emoninet2/Kingfisher-DAC16/README.md

# Kingfisher-DAC16
A 16 channel. 16-bit DAC board.
