emoninet2/Kingfisher-DAC16/Board/V1RevB/Kingfisher.kicad_pcb

## KiCad design Board/V1RevB/Kingfisher.kicad_pcb (2024-11-22)

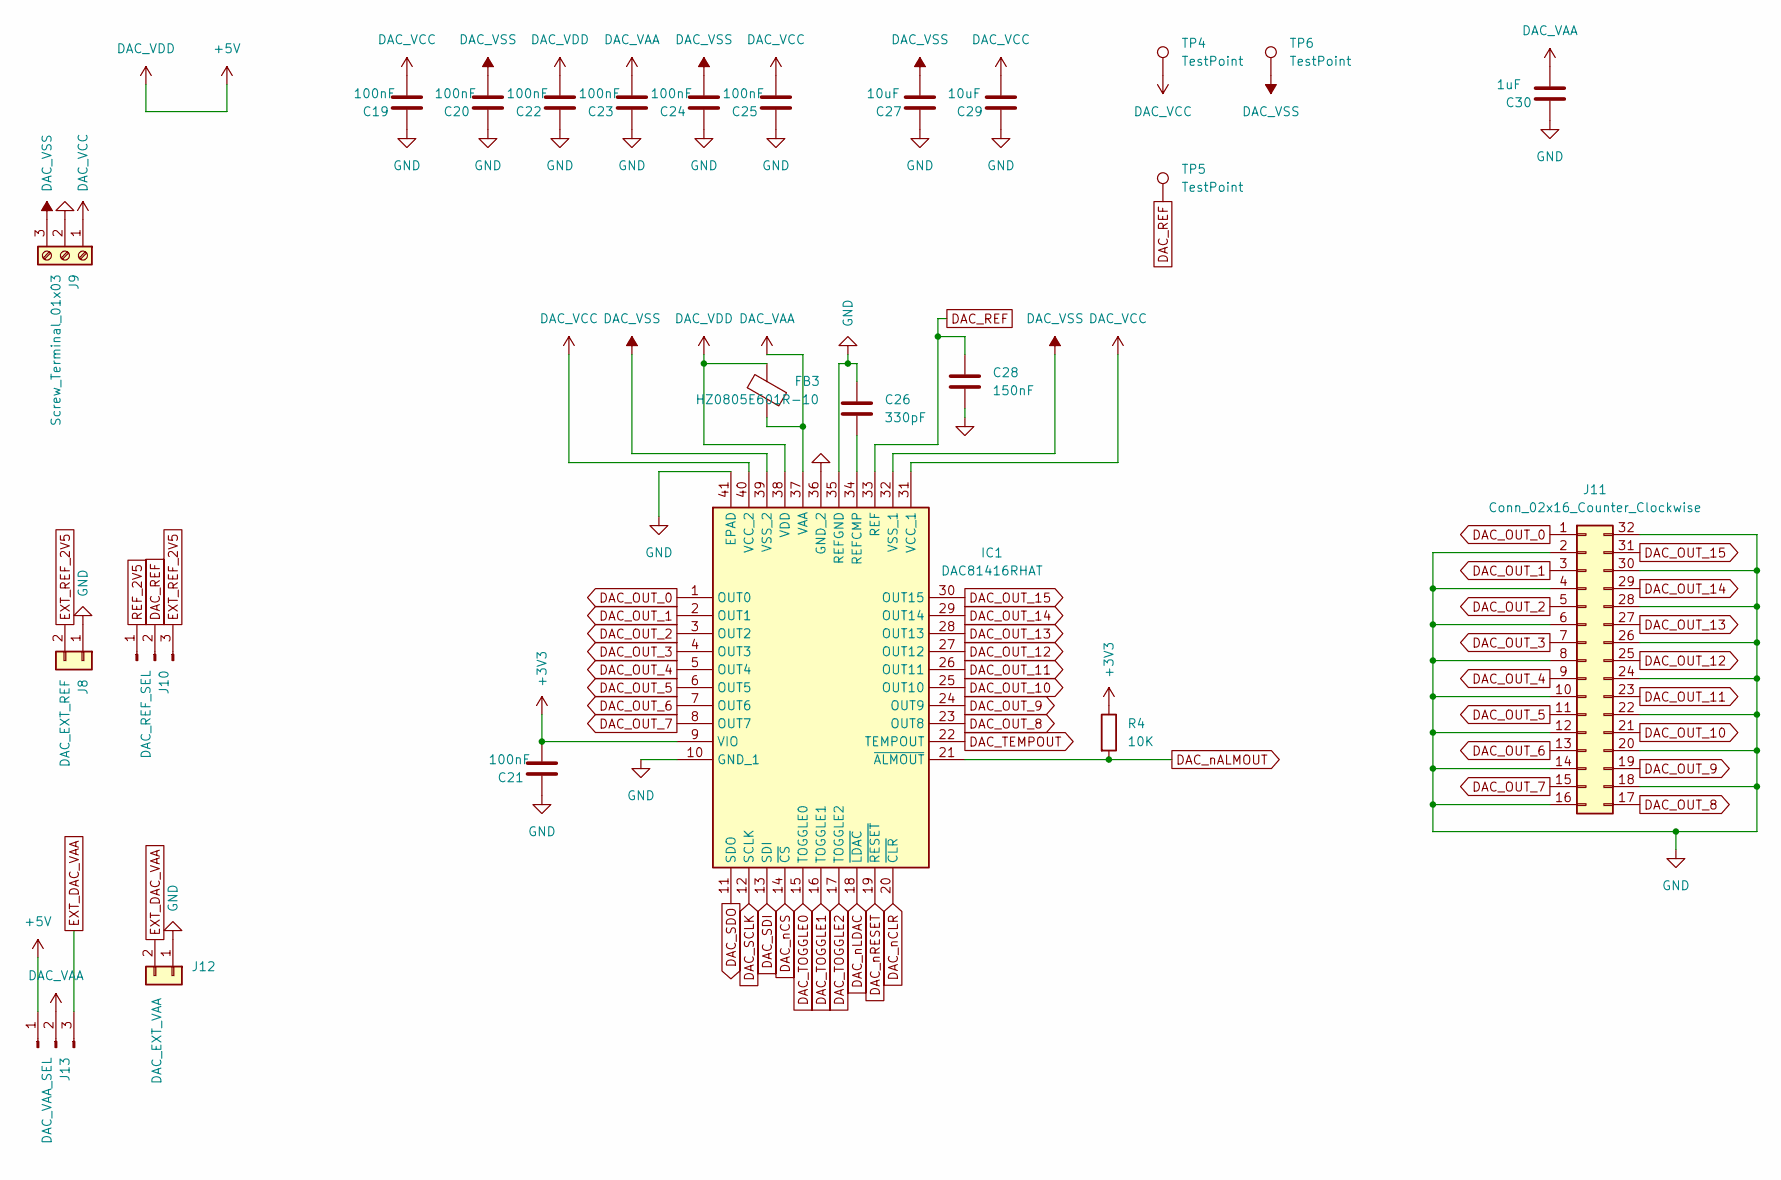
[picture p1: schematic dac_module.kicad_sch]

Parts:
C19, C20, C21, C22, C23, C24, C25: 100nF; C_0805_2012Metric; Manufacturer_Part_Number CL21B104KBCNNNC; LCSC C1711
C26: 330pF; C_0805_2012Metric; Mouser Part Number 08052C331KAT2A; Digi-Key Part Number 478-KGM21NR72D331KTCT-ND
C27, C29: 10uF; C_0805_2012Metric; Manufacturer_Part_Number CL21A106KOQNNNG; LCSC C307520
C28: 150nF; C_0805_2012Metric; Mouser Part Number C0805C154K5RACAUTO; Digi-Key Part Number 399-15888-1-ND
C30: 1uF; C_0805_2012Metric; Manufacturer_Part_Number CL21A105KBCLNNC; LCSC C318694
FB3: HZ0805E601R-10; L_0805_2012Metric; Manufacturer_Part_Number HZ0805E601R-10; Digi-Key Part Number 240-2399-1-ND
IC1: DAC81416RHAT; QFN50P600X600X100-41N-D; Mouser Part Number DAC81416RHAT
J8: DAC_EXT_REF; PinHeader_1x02_P2.54mm_Horizontal; Mouser Part Number MC34745; Farnell 1593426
J9: Screw_Terminal_01x03; TerminalBlock_MetzConnect_Type059_RT06303HBWC_1x03_P3.50mm_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; Mouser Part Number METZ CONNECT; Farnell 31059103
J10: DAC_REF_SEL; PinHeader_1x03_P2.54mm_Vertical; Manufacturer_Part_Number TSW-103-14-TM-S; Farnell 3398484
J11: Conn_02x16_Counter_Clockwise; PinSocket_2x16_P2.54mm_Horizontal; Mouser Part Number SSW-108-02-F-D-RA; Farnell 3661253
J12: DAC_EXT_VAA; PinHeader_1x02_P2.54mm_Horizontal; Mouser Part Number MC34745; Farnell 1593426
J13: DAC_VAA_SEL; PinHeader_1x03_P2.54mm_Vertical; Manufacturer_Part_Number TSW-103-14-TM-S; Farnell 3398484
R4: 10K; R_0805_2012Metric; Mouser Part Number CRCW080510K0JNEAIF; Farnell 1739242
TP4, TP5, TP6: TestPoint; TestPoint_Pad_1.0x1.0mm

Connections:
+3V3: C21.2, IC1.9 (VIO), R4.1; also elsewhere on the board
+5V: C22.2, FB3.1, IC1.38 (VDD), J13.1; also elsewhere on the board
DAC_OUT_0: IC1.1 (OUT0), J11.1
DAC_OUT_1: IC1.2 (OUT1), J11.3
DAC_OUT_2: IC1.3 (OUT2), J11.5
DAC_OUT_3: IC1.4 (OUT3), J11.7
DAC_OUT_4: IC1.5 (OUT4), J11.9
DAC_OUT_5: IC1.6 (OUT5), J11.11
DAC_OUT_6: IC1.7 (OUT6), J11.13
DAC_OUT_7: IC1.8 (OUT7), J11.15
DAC_OUT_8: IC1.23 (OUT8), J11.17
DAC_OUT_9: IC1.24 (OUT9), J11.19
DAC_OUT_10: IC1.25 (OUT10), J11.21
DAC_OUT_11: IC1.26 (OUT11), J11.23
DAC_OUT_12: IC1.27 (OUT12), J11.25
DAC_OUT_13: IC1.28 (OUT13), J11.27
DAC_OUT_14: IC1.29 (OUT14), J11.29
DAC_OUT_15: IC1.30 (OUT15), J11.31
DAC_REF: C28.1, IC1.33 (REF), J10.2, TP5.1
DAC_SCLK: IC1.12 (SCLK); also elsewhere on the board
DAC_SDI: IC1.13 (SDI); also elsewhere on the board
DAC_SDO: IC1.11 (SDO); also elsewhere on the board
DAC_TEMPOUT: IC1.22 (TEMPOUT)
DAC_TOGGLE0: IC1.15 (TOGGLE0); also elsewhere on the board
DAC_TOGGLE1: IC1.16 (TOGGLE1); also elsewhere on the board
DAC_TOGGLE2: IC1.17 (TOGGLE2); also elsewhere on the board
DAC_VAA: C23.2, C30.2, FB3.2, IC1.37 (VAA), J13.2
DAC_VCC: C19.2, C25.2, C29.2, IC1.31 (VCC_1), IC1.40 (VCC_2), J9.1, TP4.1
DAC_VSS: C20.2, C24.2, C27.2, IC1.32 (VSS_1), IC1.39 (VSS_2), J9.3, TP6.1
DAC_nALMOUT: IC1.21 (~ALMOUT), R4.2; also elsewhere on the board
DAC_nCLR: IC1.20 (~CLR); also elsewhere on the board
DAC_nCS: IC1.14 (~CS); also elsewhere on the board
DAC_nLDAC: IC1.18 (~LDAC); also elsewhere on the board
DAC_nRESET: IC1.19 (~RESET); also elsewhere on the board
EXT_DAC_VAA: J12.2, J13.3
EXT_REF_2V5: J8.2, J10.3
GND: C19.1, C20.1, C21.1, C22.1, C23.1, C24.1, C25.1, C26.1, C27.1, C28.2, C29.1, C30.1, IC1.10 (GND_1), IC1.35 (REFGND), IC1.36 (GND_2), IC1.41 (EPAD), J8.1, J9.2, J11.2, J11.4, J11.6, J11.8, J11.10, J11.12, J11.14, J11.16, J11.18, J11.20, J11.22, J11.24, J11.26, J11.28, J11.30, J11.32, J12.1; also elsewhere on the board
unnamed: C26.2, IC1.34 (REFCMP)
REF_2V5: J10.1; also elsewhere on the board

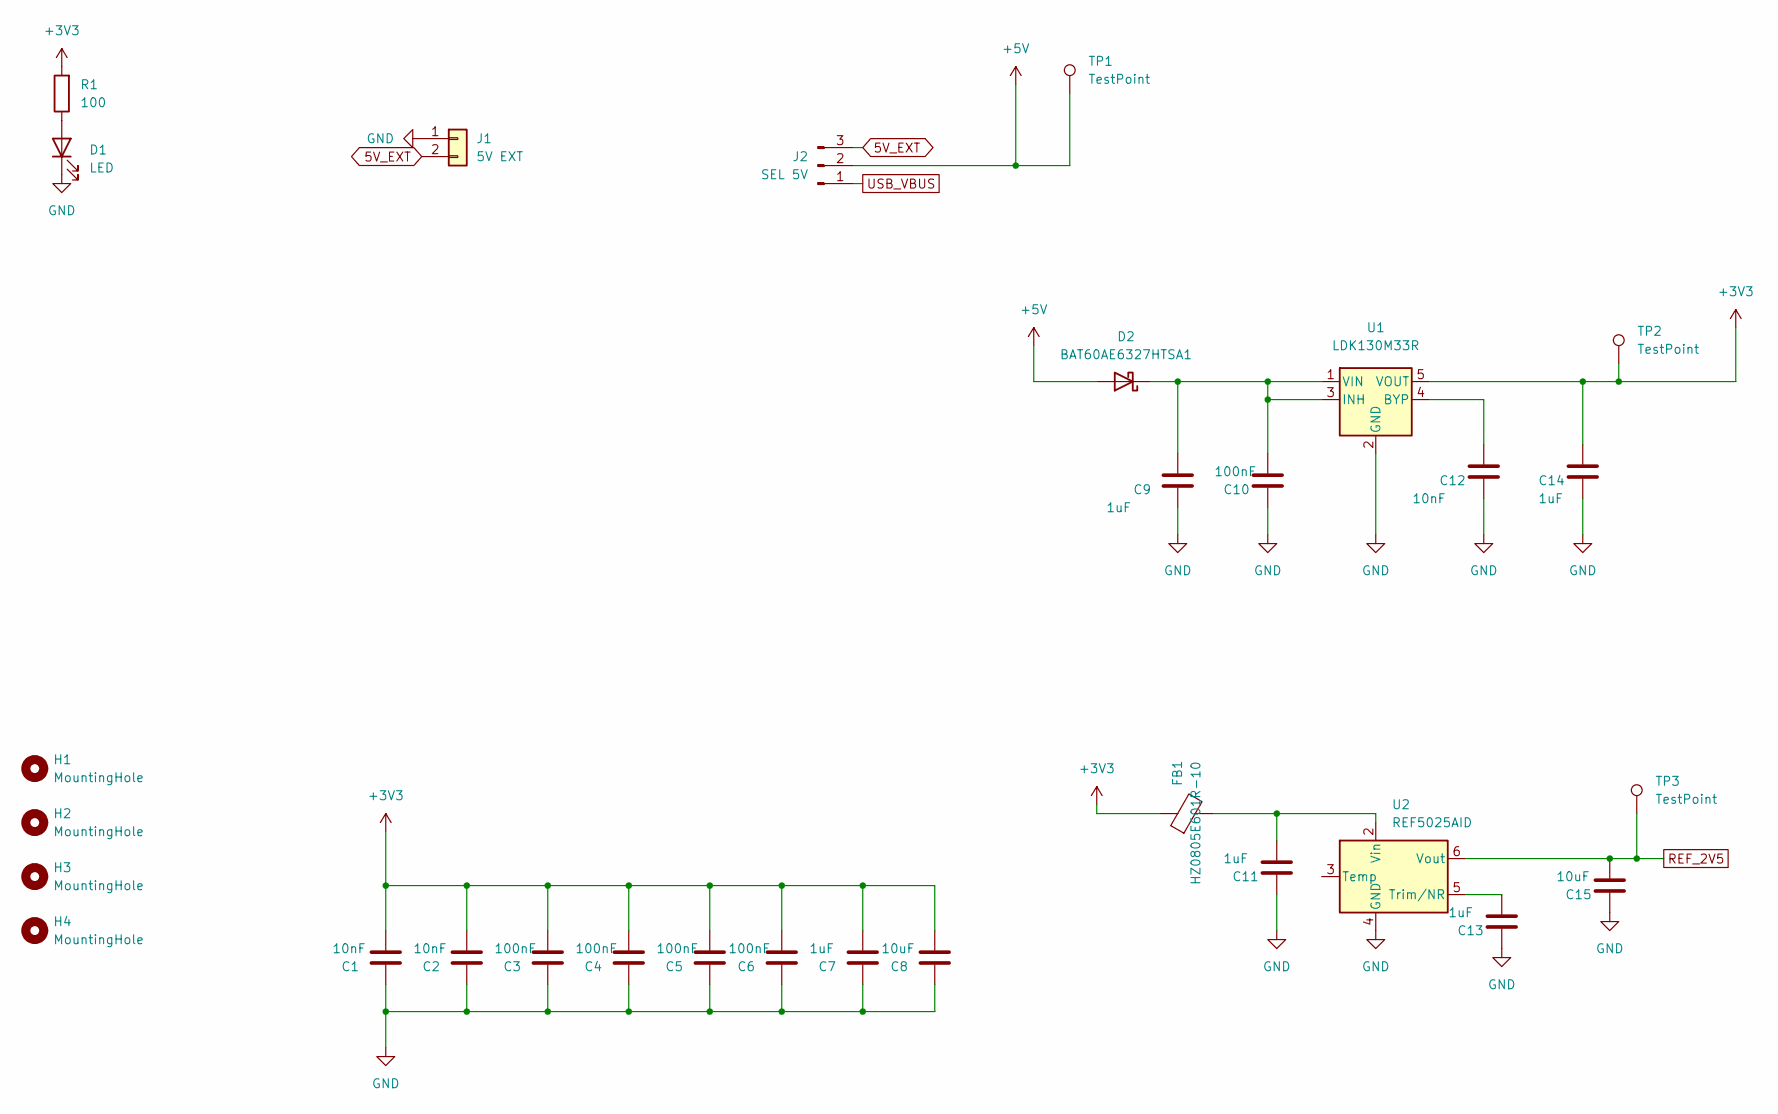
[picture p2: schematic power.kicad_sch]

Parts:
C1, C2, C12: 10nF; C_0805_2012Metric; Manufacturer_Part_Number CL21B103KBANNNC; LCSC C1710
C3, C4, C5, C6, C10: 100nF; C_0805_2012Metric; Manufacturer_Part_Number CL21B104KBCNNNC; LCSC C1711
C7, C9, C11, C13, C14: 1uF; C_0805_2012Metric; Manufacturer_Part_Number CL21A105KBCLNNC; LCSC C318694
C8, C15: 10uF; C_0805_2012Metric; Manufacturer_Part_Number CL21A106KOQNNNG; LCSC C307520
D1: LED; LED_0805_2012Metric; Manufacturer_Part_Number LTST-C191KRKT; LCSC C125099
D2: BAT60AE6327HTSA1; D_SOD-323; Manufacturer_Part_Number BAT60AE6327HTSA1; Digi-Key Part Number BAT60AE6327HTSA1CT-ND
FB1: HZ0805E601R-10; L_0805_2012Metric; Manufacturer_Part_Number HZ0805E601R-10; Digi-Key Part Number 240-2399-1-ND
H1, H2, H3, H4: MountingHole; MountingHole_3mm
J1: 5V EXT; PinHeader_1x02_P2.54mm_Horizontal; Manufacturer_Part_Number TSW-102-14-TM-S; Farnell 1593426
J2: SEL 5V; PinHeader_1x03_P2.54mm_Vertical; Manufacturer_Part_Number TSW-103-14-TM-S; Farnell 3398484
R1: 100; R_0805_2012Metric; Manufacturer_Part_Number AC0805FR-07100RL; Farnell 1652906
TP1, TP2, TP3: TestPoint; TestPoint_Pad_1.0x1.0mm
U1: LDK130M33R; SOT-23-5; Manufacturer_Part_Number LD3985M33R; LCSC C46243
U2: REF5025AID; SOIC-8_3.9x4.9mm_P1.27mm; Mouser Part Number REF5025AID; Digi-Key Part Number 296-22203-5-ND

Connections:
5V_EXT: J1.2, J2.3
+3V3: C1.2, C2.2, C3.2, C4.2, C5.2, C6.2, C7.2, C8.2, C14.2, FB1.1, R1.2, TP2.1, U1.5 (VOUT); also elsewhere on the board
+5V: D2.2 (A), J2.2, TP1.1; also elsewhere on the board
GND: C1.1, C2.1, C3.1, C4.1, C5.1, C6.1, C7.1, C8.1, C9.1, C10.1, C11.1, C12.1, C13.1, C14.1, C15.1, D1.1 (K), J1.1, U1.2 (GND), U2.4 (GND); also elsewhere on the board
unnamed: D1.2 (A), R1.1
unnamed: C9.2, C10.2, D2.1 (K), U1.1 (VIN), U1.3 (INH)
unnamed: C12.2, U1.4 (BYP)
unnamed: C13.2, U2.5 (Trim/NR)
unnamed: C11.2, FB1.2, U2.2 (Vin)
REF_2V5: C15.2, TP3.1, U2.6 (Vout); also elsewhere on the board
USB_VBUS: J2.1; also elsewhere on the board

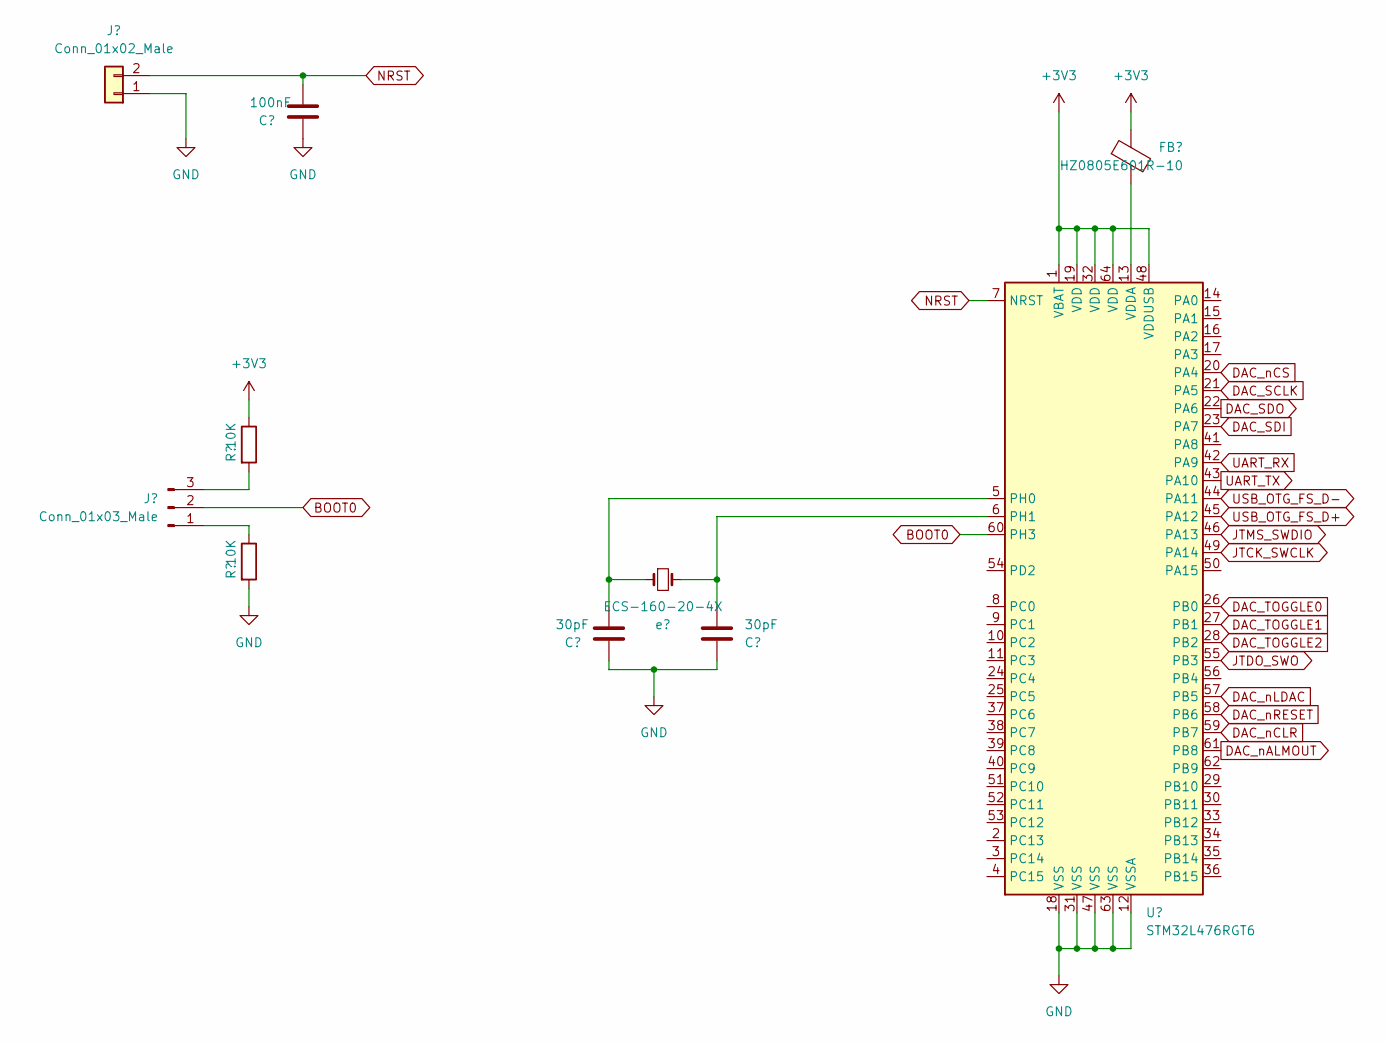
[picture p3: schematic mcu.kicad_sch]

Parts:
C16: 100nF; C_0805_2012Metric; Manufacturer_Part_Number CL21B104KBCNNNC; LCSC C1711
C17, C18: 30pF; C_0805_2012Metric; Manufacturer_Part_Number CL21C200JBANNNC; LCSC C1798
FB2: HZ0805E601R-10; L_0805_2012Metric; Manufacturer_Part_Number HZ0805E601R-10; Digi-Key Part Number 240-2399-1-ND
J3: Conn_01x02_Male; PinHeader_1x02_P2.54mm_Horizontal; Manufacturer_Part_Number TSW-102-14-TM-S; Farnell MC34745
J4: Conn_01x03_Male; PinHeader_1x03_P2.54mm_Vertical; Manufacturer_Part_Number TSW-103-14-TM-S; Farnell 3398484
R2, R3: 10K; R_0805_2012Metric; Manufacturer_Part_Number ERA-6AEB103V; Farnell 1739242
U3: STM32L476RGT6; LQFP-64_10x10mm_P0.5mm; Manufacturer_Part_Number STM32L476RGT6; LCSC C74797
e1: ECS-160-20-4X; Crystal_HC49-4H_Vertical; Manufacturer_Part_Number 9B-16.000MAAE-B; LCSC C2636524

Connections:
+3V3: FB2.1, R2.1, U3.1 (VBAT), U3.19 (VDD), U3.32 (VDD), U3.48 (VDDUSB), U3.64 (VDD); also elsewhere on the board
BOOT0: J4.2, U3.60 (PH3)
DAC_SCLK: U3.21 (PA5); also elsewhere on the board
DAC_SDI: U3.23 (PA7); also elsewhere on the board
DAC_SDO: U3.22 (PA6); also elsewhere on the board
DAC_TOGGLE0: U3.26 (PB0); also elsewhere on the board
DAC_TOGGLE1: U3.27 (PB1); also elsewhere on the board
DAC_TOGGLE2: U3.28 (PB2); also elsewhere on the board
DAC_nALMOUT: U3.61 (PB8); also elsewhere on the board
DAC_nCLR: U3.59 (PB7); also elsewhere on the board
DAC_nCS: U3.20 (PA4); also elsewhere on the board
DAC_nLDAC: U3.57 (PB5); also elsewhere on the board
DAC_nRESET: U3.58 (PB6); also elsewhere on the board
GND: C16.1, C17.1, C18.1, J3.1, R3.2, U3.12 (VSSA), U3.18 (VSS), U3.31 (VSS), U3.47 (VSS), U3.63 (VSS); also elsewhere on the board
JTCK_SWCLK: U3.49 (PA14); also elsewhere on the board
JTDO_SWO: U3.55 (PB3); also elsewhere on the board
JTMS_SWDIO: U3.46 (PA13); also elsewhere on the board
NRST: C16.2, J3.2, U3.7 (NRST); also elsewhere on the board
unnamed: J4.1, R3.1
unnamed: J4.3, R2.2
unnamed: C17.2, U3.5 (PH0), e1.1
unnamed: C18.2, U3.6 (PH1), e1.2
unnamed: FB2.2, U3.13 (VDDA)
UART_RX: U3.42 (PA9); also elsewhere on the board
UART_TX: U3.43 (PA10); also elsewhere on the board
USB_OTG_FS_D+: U3.45 (PA12); also elsewhere on the board
USB_OTG_FS_D-: U3.44 (PA11); also elsewhere on the board

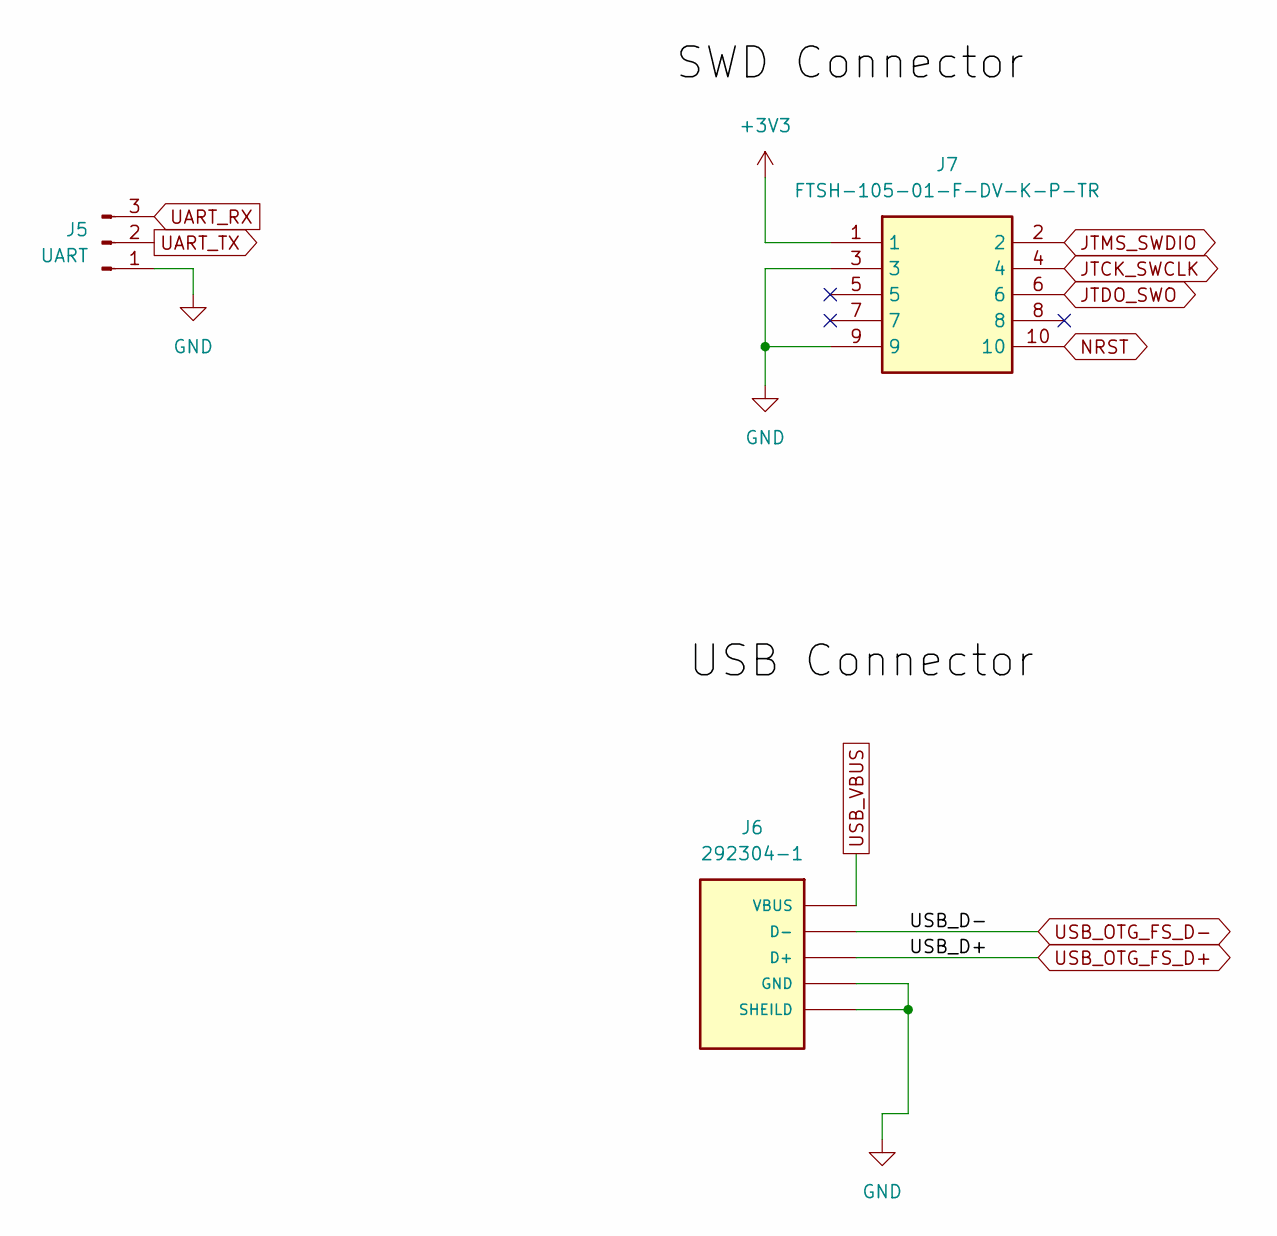
[picture p4: schematic connectors.kicad_sch]

Parts:
J5: UART; PinHeader_1x03_P2.54mm_Horizontal; Manufacturer_Part_Number TSW-103-14-TM-S; Farnell 1593427
J6: 292304-1; TE_292304-1; Manufacturer_Part_Number 292304-1; LCSC C86462
J7: FTSH-105-01-F-DV-K-P-TR; FTSH-105-XX-YYY-DV-K-P-TR; Mouser Part Number FTSH-105-01-F-DV-K-P-TR

Connections:
+3V3: J7.1; also elsewhere on the board
GND: J5.1, J6.0 (SHEILD), J6.4 (GND), J7.3, J7.9; also elsewhere on the board
JTCK_SWCLK: J7.4; also elsewhere on the board
JTDO_SWO: J7.6; also elsewhere on the board
JTMS_SWDIO: J7.2; also elsewhere on the board
NRST: J7.10; also elsewhere on the board
UART_RX: J5.3; also elsewhere on the board
UART_TX: J5.2; also elsewhere on the board
USB_OTG_FS_D+: J6.3 (D+); also elsewhere on the board
USB_OTG_FS_D-: J6.2 (D-); also elsewhere on the board
USB_VBUS: J6.1 (VBUS); also elsewhere on the board

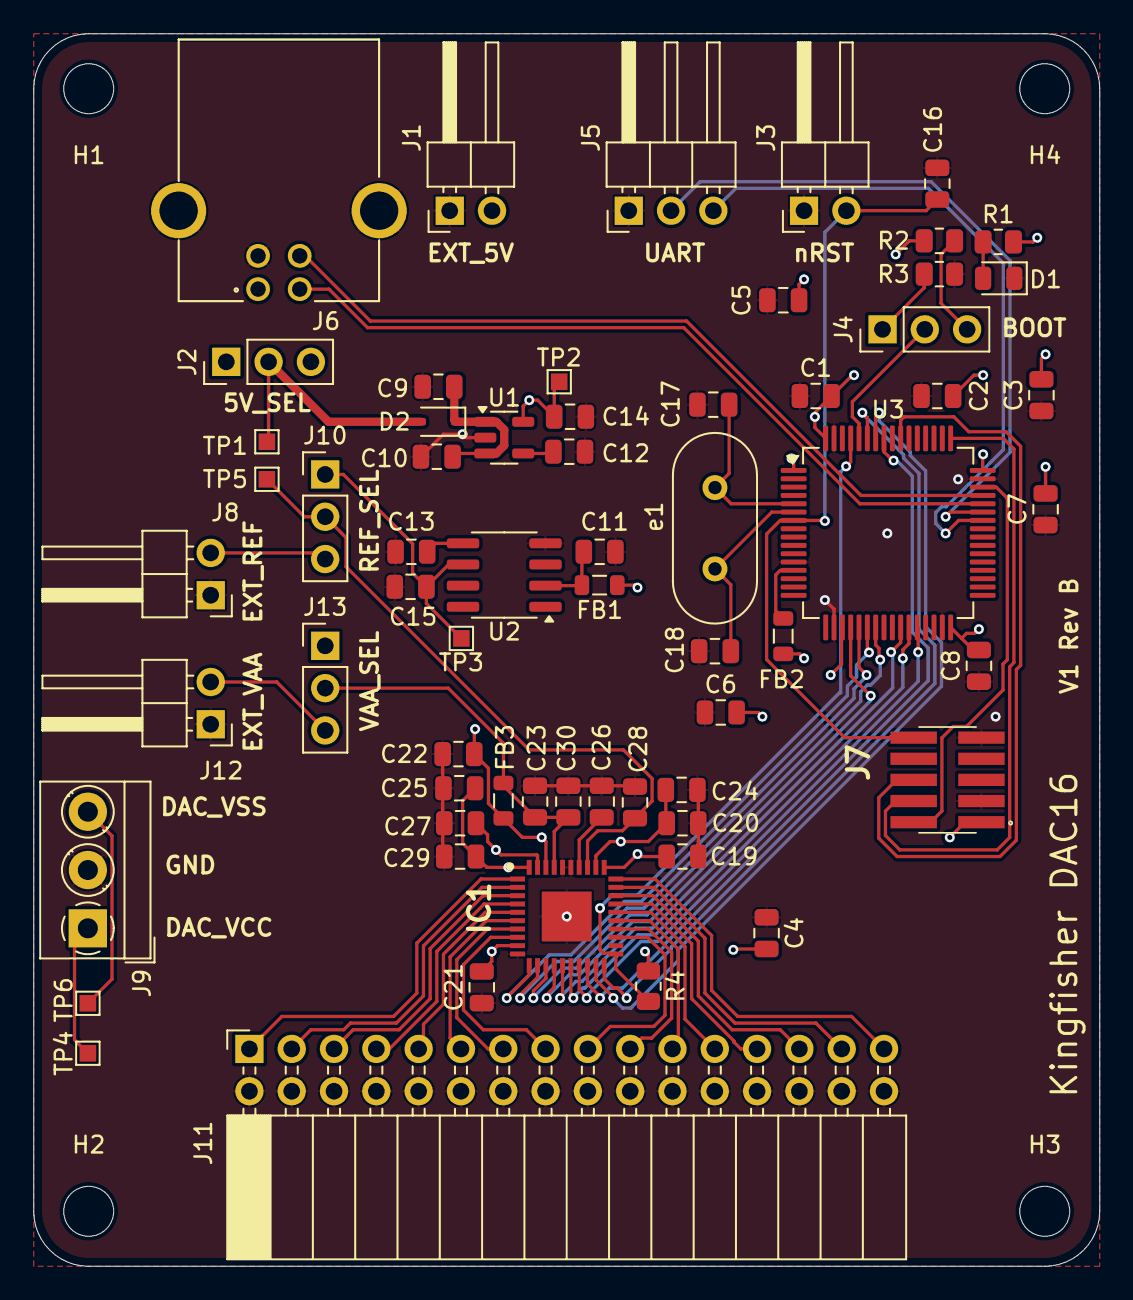
[picture p5: board Board/V1RevB/Kingfisher.kicad_pcb from above]

Board: 4 copper layers, 64.0 x 74.0 mm, 67 parts (0 on the bottom side), 59 nets.
