emoninet2/Kingfisher-DAC16/Board/V1RevA/Kingfisher.kicad_pcb

## KiCad design Board/V1RevA/Kingfisher.kicad_pcb (2024-10-19)

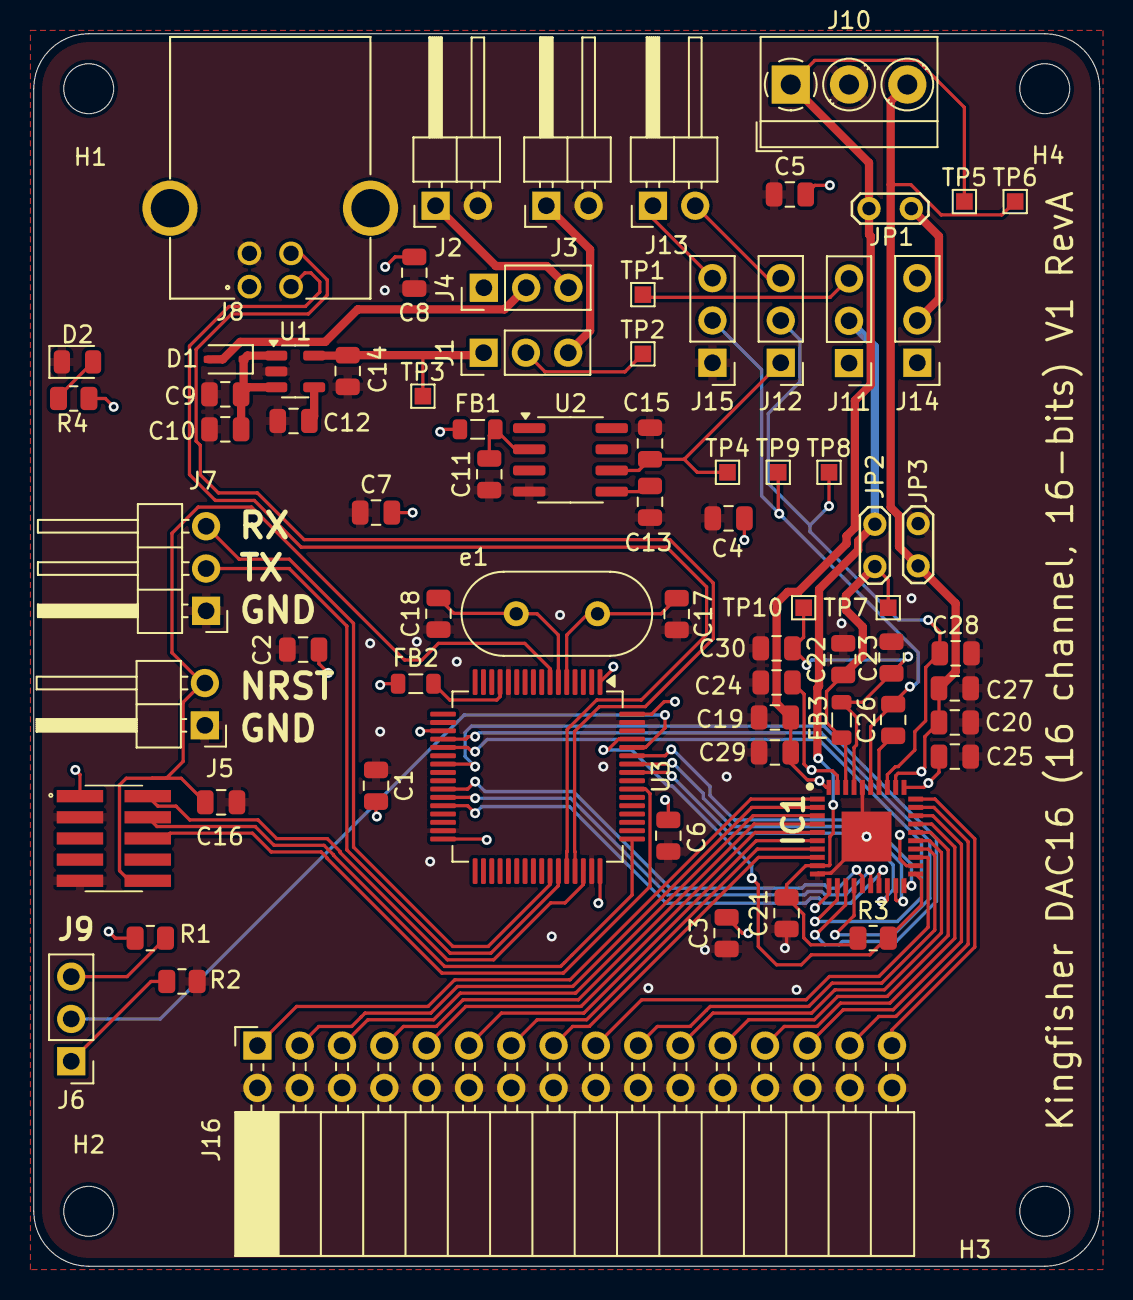
[picture p6: board Board/V1RevA/Kingfisher.kicad_pcb from above]

Board: 4 copper layers, 64.0 x 74.0 mm, 77 parts (0 on the bottom side), 64 nets.

Parts:
C1, C2, C12: 10nF; C_0805_2012Metric
C3, C4, C5, C6, C10, C16, C19, C20, C21, C22, C23, C24, C25: 100nF; C_0805_2012Metric
C7, C9, C11, C13, C14, C30: 1uF; C_0805_2012Metric
C8, C15, C27, C29: 10uF; C_0805_2012Metric
C17, C18: 30pF; C_0805_2012Metric
C26: 330pF; C_0805_2012Metric
C28: 150nF; C_0805_2012Metric
D1: BAT60AE6327HTSA1; D_SOD-323
D2: LED; LED_0805_2012Metric
FB1, FB2, FB3: HZ0805E601R-10; L_0805_2012Metric
H1, H2, H3, H4: MountingHole; MountingHole_3mm
IC1: DAC81416RHAT; QFN50P600X600X100-41N-D
J1: SEL 3V3; PinHeader_1x03_P2.54mm_Vertical
J2: 5V EXT; PinHeader_1x02_P2.54mm_Horizontal
J3: 3V3 EXT; PinHeader_1x02_P2.54mm_Horizontal
J4: SEL 5V; PinHeader_1x03_P2.54mm_Vertical
J5: Conn_01x02_Male; PinHeader_1x02_P2.54mm_Horizontal
J6: Conn_01x03_Male; PinHeader_1x03_P2.54mm_Vertical
J7: UART; PinHeader_1x03_P2.54mm_Horizontal
J8: 292304-1; TE_292304-1
J9: FTSH-105-01-F-DV-K-P-TR; FTSH-105-XX-YYY-DV-K-P-TR
J10: Screw_Terminal_01x03; TerminalBlock_MetzConnect_Type059_RT06303HBWC_1x03_P3.50mm_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
J11, J14: DAC_VDD_SEL; PinHeader_1x03_P2.54mm_Vertical
J12, J15: DAC_REF_SEL; PinHeader_1x03_P2.54mm_Vertical
J13: DAC_EXT_REF; PinHeader_1x02_P2.54mm_Horizontal
J16: Conn_02x16_Counter_Clockwise; PinSocket_2x16_P2.54mm_Horizontal
JP1, JP2, JP3: Jumper_01x02_2.54mm; TestPoint_2Pads_Pitch2.54mm_Drill0.8mm
R1, R2, R3: 10K; R_0805_2012Metric
R4: 100; R_0805_2012Metric
TP1, TP2, TP3, TP4, TP5, TP6, TP7, TP8, TP9, TP10: TestPoint; TestPoint_Pad_1.0x1.0mm
U1: LDK130M33R; SOT-23-5
U2: REF5025AID; SOIC-8_3.9x4.9mm_P1.27mm
U3: STM32L476RGT6; LQFP-64_10x10mm_P0.5mm
e1: ECS-160-20-4X; Crystal_HC49-4H_Vertical

Connections:
3.3V_EXT: J1.3, J3.1
3.3V_REG: C14.2, J1.1, TP3.1, U1.5 (VOUT)
5V_EXT: J2.1, J4.3
+3V3: C1.2, C2.2, C3.2, C4.2, C5.2, C6.2, C7.2, C8.2, FB1.1, FB2.1, J1.2, J9.1, J11.1, J14.1, R1.1, R4.2, TP2.1, U3.1 (VBAT), U3.19 (VDD), U3.32 (VDD), U3.48 (VDDUSB), U3.64 (VDD)
+5V: D1.2 (A), J4.2, J11.3, J14.3, TP1.1
BOOT0: J6.2, U3.60 (PH3)
DAC_GNDREF: C26.1, IC1.35 (REFGND), J15.2, TP9.1
DAC_OUT_0: IC1.1 (OUT0), J16.1
DAC_OUT_1: IC1.2 (OUT1), J16.3
DAC_OUT_2: IC1.3 (OUT2), J16.5
DAC_OUT_3: IC1.4 (OUT3), J16.7
DAC_OUT_4: IC1.5 (OUT4), J16.9
DAC_OUT_5: IC1.6 (OUT5), J16.11
DAC_OUT_6: IC1.7 (OUT6), J16.13
DAC_OUT_7: IC1.8 (OUT7), J16.15
DAC_OUT_8: IC1.23 (OUT8), J16.17
DAC_OUT_9: IC1.24 (OUT9), J16.19
DAC_OUT_10: IC1.25 (OUT10), J16.21
DAC_OUT_11: IC1.26 (OUT11), J16.23
DAC_OUT_12: IC1.27 (OUT12), J16.25
DAC_OUT_13: IC1.28 (OUT13), J16.27
DAC_OUT_14: IC1.29 (OUT14), J16.29
DAC_OUT_15: IC1.30 (OUT15), J16.31
DAC_REF: C28.1, IC1.33 (REF), J12.2, TP8.1
DAC_SCLK: IC1.12 (SCLK), U3.21 (PA5)
DAC_SDI: IC1.13 (SDI), U3.23 (PA7)
DAC_TOGGLE0: IC1.15 (TOGGLE0), U3.26 (PB0)
DAC_TOGGLE1: IC1.16 (TOGGLE1), U3.27 (PB1)
DAC_TOGGLE2: IC1.17 (TOGGLE2), U3.28 (PB2)
DAC_VAA: C23.2, C30.2, FB3.2, IC1.37 (VAA), TP10.1
DAC_VCC: C19.2, C25.2, C29.2, IC1.31 (VCC_1), IC1.40 (VCC_2), J10.1, JP1.1 (A), TP5.1
DAC_VDD: C22.2, FB3.1, IC1.38 (VDD), JP2.2 (B), TP7.1
DAC_VIO: C21.2, IC1.9 (VIO), J11.2, JP2.1 (A), R3.1
DAC_VSS: C20.2, C24.2, C27.2, IC1.32 (VSS_1), IC1.39 (VSS_2), J10.3, JP3.1 (A), TP6.1
DAC_nALMOUT: IC1.21 (~ALMOUT), R3.2, U3.61 (PB8)
DAC_nCLR: IC1.20 (~CLR), U3.59 (PB7)
DAC_nCS: IC1.14 (~CS), U3.20 (PA4)
DAC_nLDAC: IC1.18 (~LDAC), U3.57 (PB5)
DAC_nRESET: IC1.19 (~RESET), U3.58 (PB6)
EXT_REF_2V5: J12.3, J13.2
GND: C1.1, C2.1, C3.1, C4.1, C5.1, C6.1, C7.1, C8.1, C9.1, C10.1, C11.1, C12.1, C13.1, C14.1, C15.1, C16.1, C17.1, C18.1, C19.1, C20.1, C21.1, C22.1, C23.1, C24.1, C25.1, C27.1, C28.2, C29.1, C30.1, D2.1 (K), IC1.10 (GND_1), IC1.36 (GND_2), IC1.41 (EPAD), J2.2, J3.2, J5.1, J7.1, J8.0 (SHEILD), J8.4 (GND), J9.3, J9.9, J10.2, J15.1, J16.2, J16.4, J16.6, J16.8, J16.10, J16.12, J16.14, J16.16, J16.18, J16.20, J16.22, J16.24, J16.26, J16.28, J16.30, J16.32, JP3.2 (B), R2.2, U1.2 (GND), U2.4 (GND), U3.12 (VSSA), U3.18 (VSS), U3.31 (VSS), U3.47 (VSS), U3.63 (VSS)
JTCK_SWCLK: J9.4, U3.49 (PA14)
JTDO_SWO: J9.6, U3.55 (PB3)
JTMS_SWDIO: J9.2, U3.46 (PA13)
NRST: C16.2, J5.2, J9.10, U3.7 (NRST)
unnamed: C9.2, C10.2, D1.1 (K), U1.1 (VIN), U1.3 (INH)
unnamed: D2.2 (A), R4.1
unnamed: C26.2, IC1.34 (REFCMP)
unnamed: J6.1, R2.1
unnamed: J6.3, R1.2
unnamed: J13.1, J15.3
unnamed: J14.2, JP1.2 (B)
unnamed: C12.2, U1.4 (BYP)
unnamed: C13.2, U2.5 (Trim/NR)
unnamed: C11.2, FB1.2, U2.2 (Vin)
unnamed: C17.2, U3.5 (PH0), e1.1
unnamed: C18.2, U3.6 (PH1), e1.2
unnamed: FB2.2, U3.13 (VDDA)
REF_2V5: C15.2, J12.1, TP4.1, U2.6 (Vout)
UART_RX: J7.3, U3.42 (PA9)
UART_TX: J7.2, U3.43 (PA10)
USB_OTG_FS_D+: J8.3 (D+), U3.45 (PA12)
USB_OTG_FS_D-: J8.2 (D-), U3.44 (PA11)
USB_VBUS: J4.1, J8.1 (VBUS)
