emoninet2/Kingfisher-DAC16/Firmware/workspace/kingfisher-DAC16/Core/Src/main.c

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
/* Includes ------------------------------------------------------------------*/
#include "main.h"
#include "usb_device.h"

/* USER CODE BEGIN Includes */
//#include "DACx1416_dep.h"
#include "DACx1416.h"
#include "DACx1416_port.h"
#include "usb_device.h"
#include "usbd_cdc_if.h"

#include "fifo_queue.h"
#include "slip.h"
#include "cmdParser.h"
/* USER CODE END Includes */

CRC_HandleTypeDef hcrc;

SPI_HandleTypeDef hspi1;
DMA_HandleTypeDef hdma_spi1_tx;
DMA_HandleTypeDef hdma_spi1_rx;

UART_HandleTypeDef huart1;
DMA_HandleTypeDef hdma_usart1_tx;
DMA_HandleTypeDef hdma_usart1_rx;

DMA_HandleTypeDef hdma_memtomem_dma1_channel1;
/* USER CODE BEGIN PV */
DACx1416 dacUnit;
volatile uint8_t dacUseCRC = 0;
volatile uint8_t dacTransferComplete = 1;

extern uint8_t UserRxBufferFS[APP_RX_DATA_SIZE];
FIFOQueue *cdcRxQueue;
SLIP_HandleTypeDef slip;




/* USER CODE END PV */

void SystemClock_Config(void);
static void MX_GPIO_Init(void);
static void MX_DMA_Init(void);
static void MX_SPI1_Init(void);
static void MX_USART1_UART_Init(void);
static void MX_CRC_Init(void);
/* USER CODE BEGIN 0 */





// Function to receive a single character from the CDC Rx queue
// Function to receive a single character from the CDC Rx queue (blocking)
char cdc_recv_char(void) {
    while (isEmpty(cdcRxQueue)) {
        // Wait for data to be available in the queue
        HAL_Delay(1); // Sleep for 1 ms (adjust based on your system requirements)
    }

    void *value = dequeue(cdcRxQueue);
    if (!value) {
        //printf("Failed to dequeue from CDC Rx queue.\n");
        return 0xFF;  // Return an error value if dequeue fails
    }

    // Bytes are stored as pointer-sized tagged values (byte + 1) in the CDC RX queue.
    uint8_t result = (uint8_t)(((uintptr_t)value) - 1U);
    return result;            // Return the dequeued value
}

void cdc_send_char(char ch) {
    // Cast the char to uint8_t* by passing the address of ch
    while (CDC_Transmit_FS((uint8_t*)&ch, 1) != USBD_OK) {
        // Send the character as a byte over USB
    }
}
// Function called when data is received via USB
/* USER CODE END 0 */

/**
  * @brief  The application entry point.
  * @retval int
  */
int main(void)
{

  /* MCU Configuration--------------------------------------------------------*/

  /* Reset of all peripherals, Initializes the Flash interface and the Systick. */
  HAL_Init();

  /* Configure the system clock */
  SystemClock_Config();

  /* Initialize all configured peripherals */
  MX_GPIO_Init();
  MX_DMA_Init();
  MX_SPI1_Init();
  MX_USART1_UART_Init();
  MX_USB_DEVICE_Init();
  MX_CRC_Init();
  /* USER CODE BEGIN 2 */
	//HAL_NVIC_SetPriority(SPI1_IRQn, 1, 0);
	//HAL_NVIC_EnableIRQ(SPI1_IRQn);
	dacUnit.port.SPI_transmit = DACx1416_SPI_transmit;
	dacUnit.port.SPI_receive = DACx1416_SPI_receive;
	dacUnit.port.SPI_transmitReceive = DACx1416_SPI_transmitReceive;
	dacUnit.port.nCS = DACx1416_nCS;
	dacUnit.port.nLDAC = DACx1416_nLDAC;
	dacUnit.port.nRESET = DACx1416_nRESET;
	dacUnit.port.nCLR = DACx1416_nCLR;
	dacUnit.port.TGL = DACx1416_tgl;
	dacUnit.port.calculate_crc8 = DACx1416_calculate_crc8;

	DACx1416_initialize(&dacUnit);


//	uint16_t temp;
//	uint16_t temp2;
////
////
////	DACx1416_read_register(&dacUnit, 0x01, &temp2);
////
////	DACx1416_read_register(&dacUnit, DACx1416_REG_SPICONFIG, &temp2);
////
//	temp = 0x1A2A;
//	DACx1416_write_register(&dacUnit, DACx1416_REG_DACPWDWN, &temp);
//	DACx1416_read_register(&dacUnit, DACx1416_REG_DACPWDWN, &temp2);
////
////
//	temp = 0x2A3A;
//	DACx1416_write_register(&dacUnit, DACx1416_REG_DACPWDWN, &temp);
//	DACx1416_read_register(&dacUnit, DACx1416_REG_DACPWDWN, &temp2);
//


//
//	DACx1416_read_register(&dacUnit, DACx1416_REG_SPICONFIG, &temp2);
//
//
//	temp = 0x3A4A;
//	DACx1416_write_register(&dacUnit, DACx1416_REG_DACPWDWN, &temp);
//	DACx1416_read_register(&dacUnit, DACx1416_REG_DACPWDWN, &temp2);
//
//
//	DACx1416_devicePowerDown(&dacUnit, 0);
//	DACx1416_channelRange(&dacUnit, DACx1416_DAC0, DACx1416_DACRANGE_0_to_p5);
//
//	DACx1416_devicePowerDown(&dacUnit, 1);
//	DACx1416_devicePowerDown(&dacUnit, 0);
//
//	DACx1416_channelEnable(&dacUnit, DACx1416_DAC0, 1);
////
////
//	DACx1416_crcEnable(&dacUnit, 0);
//
//	DACx1416_channelValue(&dacUnit, DACx1416_DAC0, 5000);
//	DACx1416_channelValue(&dacUnit, DACx1416_DAC0, 16383);
//	DACx1416_channelValue(&dacUnit, DACx1416_DAC0, 44000);
//	DACx1416_channelValue(&dacUnit, DACx1416_DAC0, 60000);
//	DACx1416_channelValue(&dacUnit, DACx1416_DAC0, 65535);
////




	cdcRxQueue = createQueue();
	if (!cdcRxQueue) {
		//printf("Failed to initialize the global queue.\n");
		return 1;
	}

	slip.recv_char = cdc_recv_char;
	slip.send_char = cdc_send_char;

//
//	asm("nop");
//	asm("nop");
//	asm("nop");

  /* USER CODE END 2 */

  /* Infinite loop */
  /* USER CODE BEGIN WHILE */
	uint8_t slipRxData[1024];
	uint8_t slipTxData[1024] = "HELLO";



	while (1) {
//
//		char c = cdc_recv_char();
//		printf(&c);
//		printf("\r\n");
		//cdc_send_char(c);

		uint32_t len = slip_recv_packet(&slip, slipRxData, sizeof(slipRxData));

		if (len > 0){
			//DACx1416_SPI_transmitReceive((slipRxData, slipTxData, len));
			parseCmd(&slip, slipRxData, len);
			//slip_send_packet(&slip, slipTxData, len);
		}





    /* USER CODE END WHILE */

    /* USER CODE BEGIN 3 */
	}
  /* USER CODE END 3 */
}

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
/* USER CODE BEGIN 4 */
int __io_putchar(int ch) {
	// Write character to ITM ch.0
	ITM_SendChar(ch);
	return (ch);
}

/* USER CODE END 4 */

/**
  * @brief  Period elapsed callback in non blocking mode
  * @note   This function is called  when TIM1 interrupt took place, inside
  * HAL_TIM_IRQHandler(). It makes a direct call to HAL_IncTick() to increment
  * a global variable "uwTick" used as application time base.
  * @param  htim : TIM handle
  * @retval None
  */
void HAL_TIM_PeriodElapsedCallback(TIM_HandleTypeDef *htim)
{
  if (htim->Instance == TIM1) {
    HAL_IncTick();
  }
}

/**
  * @brief  This function is executed in case of error occurrence.
  * @retval None
  */
void Error_Handler(void)
{
  /* USER CODE BEGIN Error_Handler_Debug */
	/* User can add his own implementation to report the HAL error return state */
	__disable_irq();
	while (1) {
	}
  /* USER CODE END Error_Handler_Debug */
}

#ifdef  USE_FULL_ASSERT
/**
  * @brief  Reports the name of the source file and the source line number
  *         where the assert_param error has occurred.
  * @param  file: pointer to the source file name
  * @param  line: assert_param error line source number
  * @retval None
  */
void assert_failed(uint8_t *file, uint32_t line)
{
  /* USER CODE BEGIN 6 */
  /* User can add his own implementation to report the file name and line number,
     ex: printf("Wrong parameters value: file %s on line %d\r\n", file, line) */
  /* USER CODE END 6 */
}
#endif /* USE_FULL_ASSERT */
