emoninet2/Kingfisher-DAC16/Firmware/workspace/kingfisher-DAC16/kingfisher-DAC16.ioc

Mcu.UserName=STM32L476RGTx
PA10.Signal=USART1_RX
PA11.Signal=USB_OTG_FS_DM
PA12.Signal=USB_OTG_FS_DP
PA4.GPIO_Label=DAC_nCS
PA4.Signal=GPIO_Output
PA5.Signal=SPI1_SCK
PA6.Signal=SPI1_MISO
PA7.Signal=SPI1_MOSI
PA9.Signal=USART1_TX
PB0.GPIO_Label=DAC_TOGGLE0
PB0.Signal=GPIO_Output
PB1.GPIO_Label=DAC_TOGGLE1
PB1.Signal=GPIO_Output
PB2.GPIO_Label=DAC_TOGGLE2
PB2.Signal=GPIO_Output
PB5.GPIO_Label=DAC_nLDAC
PB5.Signal=GPIO_Output
PB6.GPIO_Label=DAC_nRESET
PB6.Signal=GPIO_Output
PB7.GPIO_Label=DAC_nCLR
PB7.Signal=GPIO_Output
PB8.GPIO_Label=DAC_nALMOUT
PB8.Signal=GPXTI8
