emoninet2/Kingfisher-DAC16/Firmware/workspace/kingfisher-DAC16/Core/Inc/cmdParser.h

/*
 * cmdParser.h
 *
 *  Created on: Oct 29, 2024
 *      Author: habiburrahman
 */

#ifndef INC_CMDPARSER_H_
#define INC_CMDPARSER_H_

#include "main.h"
#include "slip.h"

typedef enum {
	CMD_WRITE_REGISTER = 0,
	CMD_READ_REGISTER,
	CMD_STREAM_WRITE_REGISTERS,
	CMD_DAC_NOP,
	CMD_GET_DAC_DEVICEID,
	CMD_GET_DAC_STATUS,
	CMD_GET_DAC_SPICONFIG,
	CMD_SET_DAC_SPICONFIG,
	CMD_GET_DAC_GENCONFIG,
	CMD_SET_DAC_GENCONFIG,
	CMD_GET_DAC_BRDCSTCONFIG,
	CMD_SET_DAC_BRDCSTCONFIG,
	CMD_GET_DAC_SYNCCONFIG,
	CMD_SET_DAC_SYNCCONFIG,
	CMD_GET_DAC_TOGGLECONFIG,
	CMD_SET_DAC_TOGGLECONFIG,
	CMD_GET_DAC_POWERDOWN,
	CMD_SET_DAC_POWERDOWN,
	CMD_SET_DAC_RANGE,
	CMD_SET_DAC_TRIGGER,
	CMD_GET_DAC_BRDCSTREG,
	CMD_SET_DAC_BRDCSTREG,
	CMD_GET_DAC_DACnREG,
	CMD_SET_DAC_DACnREG,
	CMD_GET_DAC_OFFSET,
	CMD_SET_DAC_OFFSET,
} cmd_dep_t;

typedef enum {
	CMD_READ_DAC_REGISTER = 0b00,
	CMD_WRITE_DAC_REGISTER = 0b01,
	CMD_EXTENDED_COMMANDS = 0b11
} cmd_t;

/* Lower 6 bits of first byte when bits [7:6] == CMD_EXTENDED_COMMANDS (0b11). */
typedef enum {
	EXTCMD_HARDWARE_RESET = 0,
} ExtendedCmd_t;

void parseCmd(SLIP_HandleTypeDef *slip, uint8_t *data, uint32_t len);

#endif /* INC_CMDPARSER_H_ */
