emoninet2/Kingfisher-DAC16/(commit log)

2024-10-19 added draft for V1 Rev B
    [Kingfisher.csv, Kingfisher.kicad_pcb, Kingfisher.kicad_sch, Kingfisher.xlsx, connectors.kicad_sch, dac_module.kicad_sch, mcu.kicad_sch, power.kicad_sch]
2024-10-28 renamed project name in firmware workspace
    [Kingfisher-B_Cu.gbr, Kingfisher-B_Mask.gbr, Kingfisher-B_Paste.gbr, Kingfisher-B_Silkscreen.gbr, Kingfisher-Edge_Cuts.gbr, Kingfisher-F_Cu.gbr, Kingfisher-F_Mask.gbr, Kingfisher-F_Paste.gbr]
2024-10-29 updated driver
2024-11-22 updated firmware to use SLIP. completed python driver and tested
    [Kingfisher.kicad_pcb]
2026-04-10 added extended command for hardware reset
    [cmdParser.c, cmdParser.h, kingfisher_dac16.py, test.py]
