emoninet2/Kingfisher-DAC16/(notices)

Notices in the files:
Firmware/workspace/kingfisher-DAC16/Core/Inc/main.h:
Copyright (c) 2024 STMicroelectronics.
All rights reserved.
This software is licensed under terms that can be found in the LICENSE file
